Kene-ok/ecocar_onboarding_2627/EcoCar Onboarding 26_27.kicad_pcb

## KiCad design EcoCar Onboarding 26_27.kicad_pcb (2026-11-03)

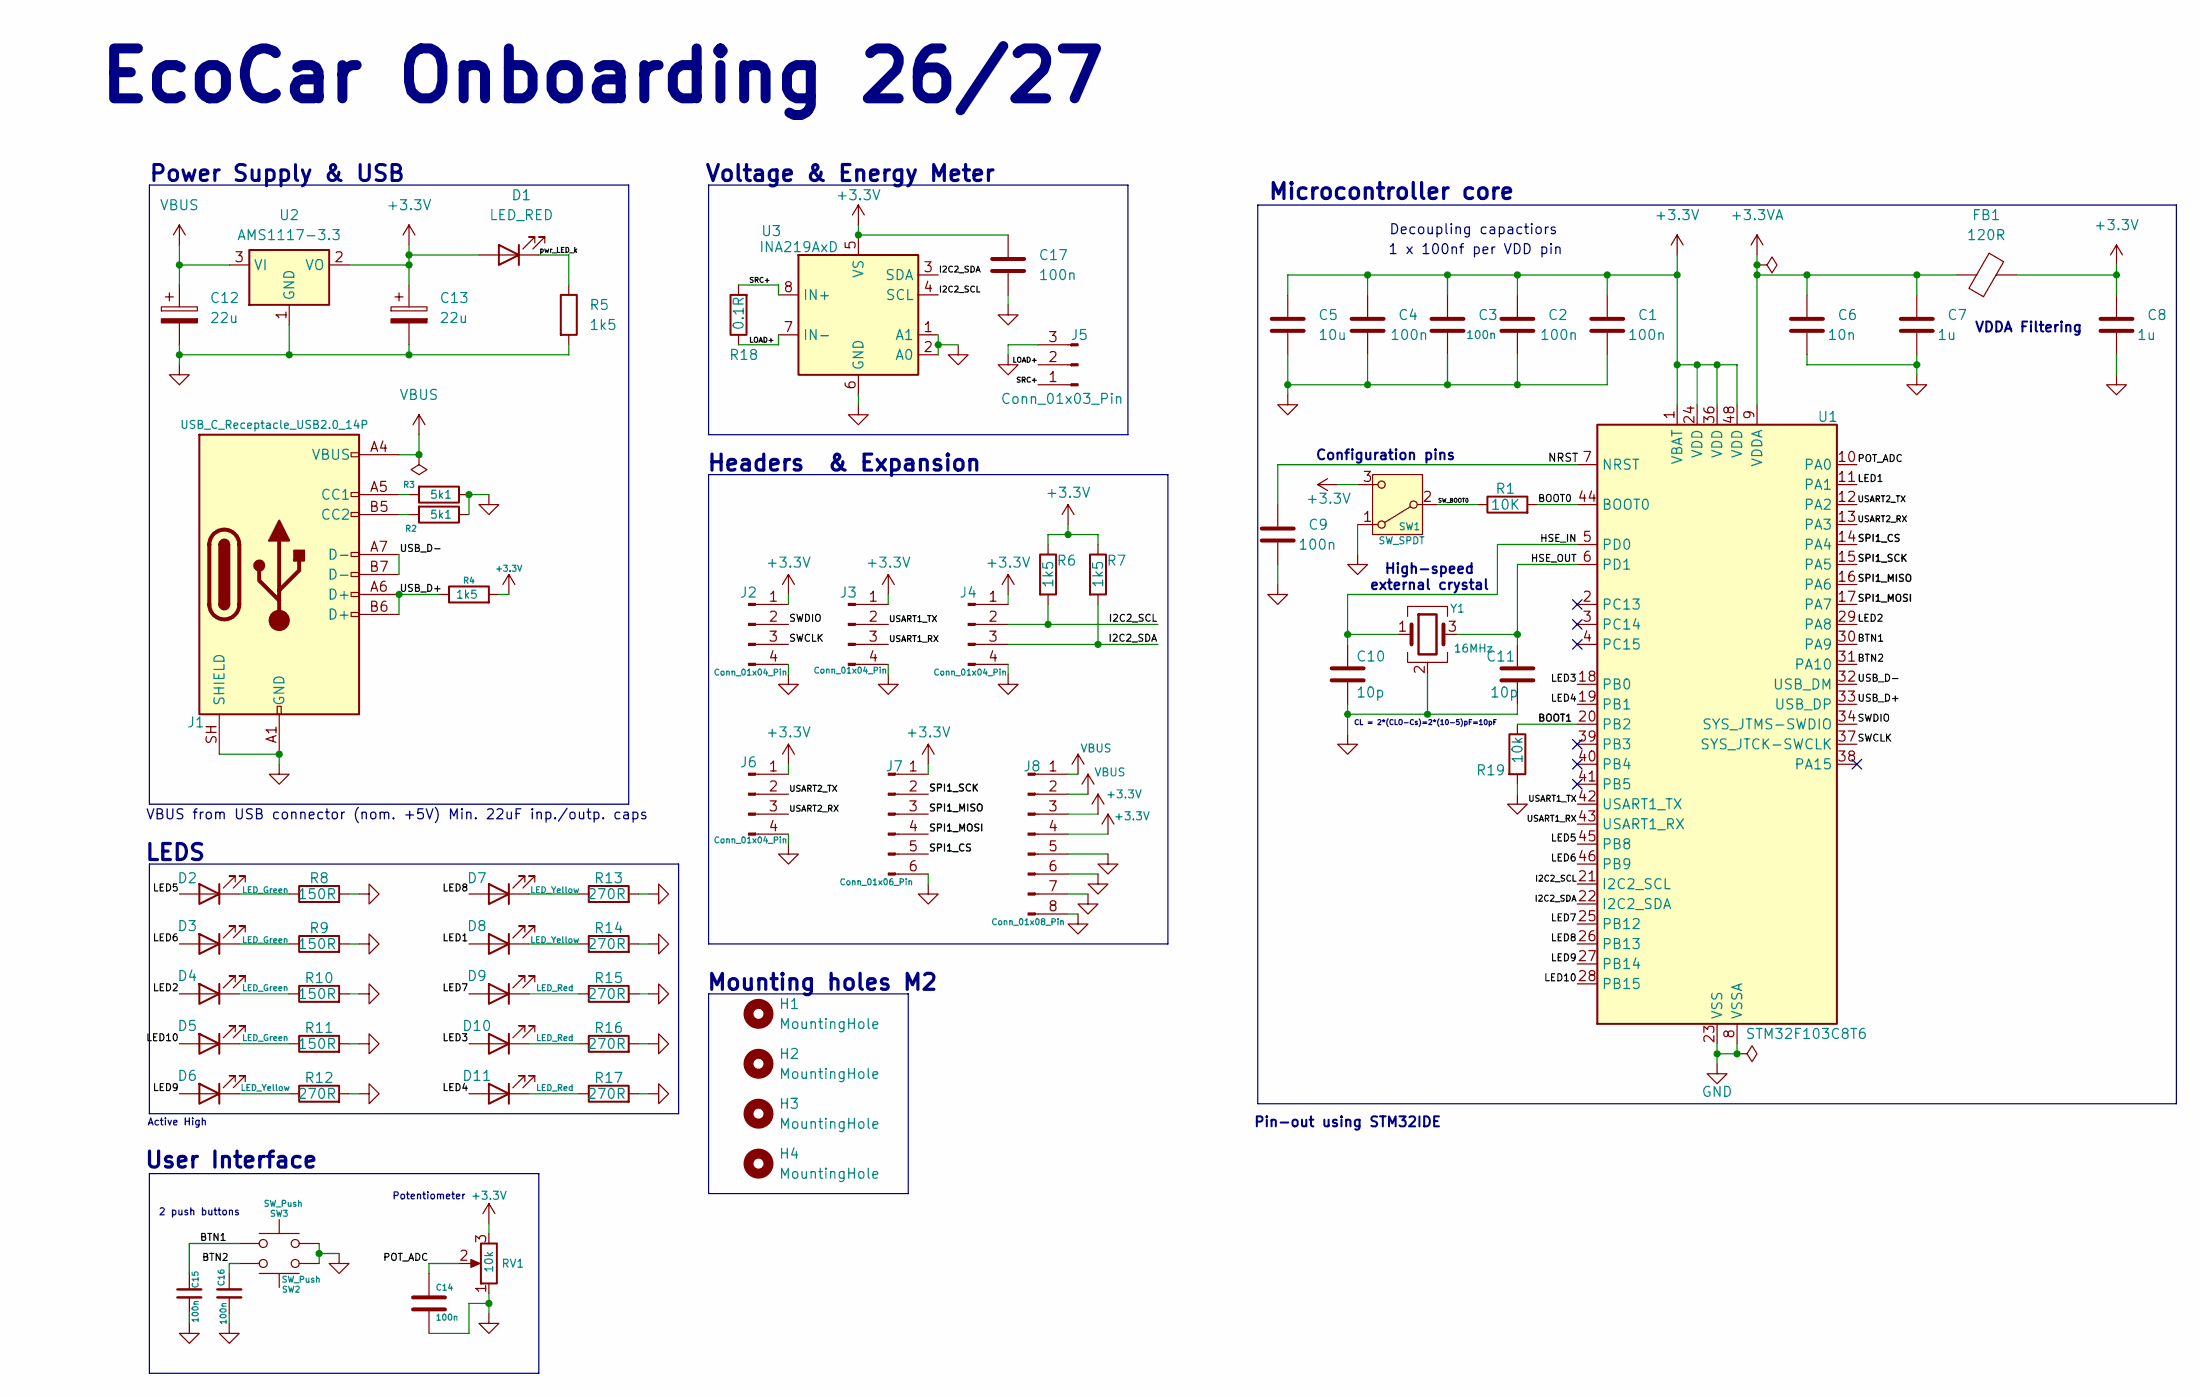
[picture p1: schematic EcoCar Onboarding 26_27.kicad_sch, EcoCar Onboarding 26/27]

Parts:
C1, C2, C3, C4, C9, C14, C15, C16, C17: 100n; C_0603_1608Metric_Pad1.08x0.95mm_HandSolder
C5: 10u; C_0603_1608Metric_Pad1.08x0.95mm_HandSolder
C6: 10n; C_0603_1608Metric_Pad1.08x0.95mm_HandSolder
C7, C8: 1u; C_0603_1608Metric_Pad1.08x0.95mm_HandSolder
C10, C11: 10p; C_0603_1608Metric_Pad1.08x0.95mm_HandSolder
C12, C13: 22u; CP_EIA-3216-18_Kemet-A
D1: LED_RED; LED_0603_1608Metric_Pad1.05x0.95mm_HandSolder
D2, D3, D4, D5: LED_Green; LED_0603_1608Metric_Pad1.05x0.95mm_HandSolder
D6, D7, D8: LED_Yellow; LED_0603_1608Metric_Pad1.05x0.95mm_HandSolder
D9, D10, D11: LED_Red; LED_0603_1608Metric_Pad1.05x0.95mm_HandSolder
FB1: 120R; L_0603_1608Metric_Pad1.05x0.95mm_HandSolder
H1, H2, H3, H4: MountingHole; MountingHole_2.2mm_M2_DIN965
J1: USB_C_Receptacle_USB2.0_14P; USB_C_Receptacle_HRO_TYPE-C-31-M-12
J2, J3, J4, J6: Conn_01x04_Pin; PinHeader_1x04_P2.54mm_Vertical
J5: Conn_01x03_Pin; PinHeader_1x03_P2.54mm_Vertical
J7: Conn_01x06_Pin; PinHeader_1x06_P2.54mm_Vertical
J8: Conn_01x08_Pin; PinHeader_1x08_P2.54mm_Vertical
R1: 10K; R_0603_1608Metric_Pad0.98x0.95mm_HandSolder
R2, R3: 5k1; R_0603_1608Metric_Pad0.98x0.95mm_HandSolder
R4, R5, R6, R7: 1k5; R_0603_1608Metric_Pad0.98x0.95mm_HandSolder
R8, R9, R10, R11: 150R; R_0603_1608Metric_Pad0.98x0.95mm_HandSolder
R12, R13, R14, R15, R16, R17: 270R; R_0603_1608Metric_Pad0.98x0.95mm_HandSolder
R18: 0.1R; R_1206_3216Metric_Pad1.30x1.75mm_HandSolder
R19: 10k; R_0603_1608Metric_Pad0.98x0.95mm_HandSolder
RV1: 10k; Potentiometer_Alpha_RD901F-40-00D_Single_Vertical
SW1: SW_SPDT; SW_Slide_SPDT_Straight_CK_OS102011MS2Q
SW2, SW3: SW_Push; SW_PUSH_6mm
U1: STM32F103C8T6; LQFP-48_7x7mm_P0.5mm
U2: AMS1117-3.3; SOT-223-3_TabPin2
U3: INA219AxD; SOIC-8_3.9x4.9mm_P1.27mm
Y1: 16MHz; Crystal_SMD_3225-4Pin_3.2x2.5mm_HandSoldering

Connections:
+3.3V: C1.1, C2.1, C3.1, C4.1, C5.1, C8.1, C13.1, C17.1, D1.2 (A), FB1.2, J2.1, J3.1, J4.1, J6.1, J7.1, J8.3, J8.4, R4.2, R6.1, R7.1, RV1.3, SW1.3 (C), U1.1 (VBAT), U1.24 (VDD), U1.36 (VDD), U1.48 (VDD), U2.2 (VO), U3.5 (VS)
+3.3VA: C6.1, C7.1, FB1.1, U1.9 (VDDA)
/BOOT0: R1.2, U1.44 (BOOT0)
/BOOT1: R19.1, U1.20 (PB2)
/BTN1: C15.1, SW3.1, U1.30 (PA9)
/BTN2: C16.1, SW2.2, U1.31 (PA10)
/HSE_IN: C10.1, U1.5 (PD0), Y1.1
/HSE_OUT: C11.1, U1.6 (PD1), Y1.3
/I2C2_SCL: J4.2, R6.2, U1.21 (I2C2_SCL), U3.4 (SCL)
/I2C2_SDA: J4.3, R7.2, U1.22 (I2C2_SDA), U3.3 (SDA)
/LED1: D8.2 (A), U1.11 (PA1)
/LED2: D4.2 (A), U1.29 (PA8)
/LED3: D10.2 (A), U1.18 (PB0)
/LED4: D11.2 (A), U1.19 (PB1)
/LED5: D2.2 (A), U1.45 (PB8)
/LED6: D3.2 (A), U1.46 (PB9)
/LED7: D9.2 (A), U1.25 (PB12)
/LED8: D7.2 (A), U1.26 (PB13)
/LED9: D6.2 (A), U1.27 (PB14)
/LED10: D5.2 (A), U1.28 (PB15)
/LOAD+: J5.2, R18.1, U3.7 (IN-)
/NRST: C9.1, U1.7 (NRST)
/POT_ADC: C14.1, RV1.2, U1.10 (PA0)
/SPI1_CS: J7.5, U1.14 (PA4)
/SPI1_MISO: J7.3, U1.16 (PA6)
/SPI1_MOSI: J7.4, U1.17 (PA7)
/SPI1_SCK: J7.2, U1.15 (PA5)
/SRC+: J5.1, R18.2, U3.8 (IN+)
/SWCLK: J2.3, U1.37 (SYS_JTCK-SWCLK)
/SWDIO: J2.2, U1.34 (SYS_JTMS-SWDIO)
/SW_BOOT0: R1.1, SW1.2 (B)
/USART1_RX: J3.3, U1.43 (USART1_RX)
/USART1_TX: J3.2, U1.42 (USART1_TX)
/USART2_RX: J6.3, U1.13 (PA3)
/USART2_TX: J6.2, U1.12 (PA2)
/USB_D+: J1.A6 (D+), J1.B6 (D+), R4.1, U1.33 (USB_DP)
/USB_D-: J1.A7 (D-), J1.B7 (D-), U1.32 (USB_DM)
/pwr_LED_k: D1.1 (K), R5.1
GND: C1.2, C2.2, C3.2, C4.2, C5.2, C6.2, C7.2, C8.2, C9.2, C10.2, C11.2, C12.2, C13.2, C14.2, C15.2, C16.2, C17.2, J1.A1 (GND), J1.A12 (GND), J1.B1 (GND), J1.B12 (GND), J1.SH (SHIELD), J2.4, J3.4, J4.4, J5.3, J6.4, J7.6, J8.5, J8.6, J8.7, J8.8, R2.1, R3.1, R5.2, R8.2, R9.2, R10.2, R11.2, R12.2, R13.2, R14.2, R15.2, R16.2, R17.2, R19.2, RV1.1, SW1.1 (A), SW2.1, SW3.2, U1.8 (VSSA), U1.23 (VSS), U1.35 (VSS), U1.47 (VSS), U2.1 (GND), U3.1 (A1), U3.2 (A0), U3.6 (GND), Y1.2 (G), Y1.4 (G)
unnamed: D2.1 (K), R8.1
unnamed: D3.1 (K), R9.1
unnamed: D4.1 (K), R10.1
unnamed: D5.1 (K), R11.1
unnamed: D6.1 (K), R12.1
unnamed: D7.1 (K), R13.1
unnamed: D8.1 (K), R14.1
unnamed: D9.1 (K), R15.1
unnamed: D10.1 (K), R16.1
unnamed: D11.1 (K), R17.1
unnamed: J1.A5 (CC1), R3.2
unnamed: J1.B5 (CC2), R2.2
VBUS: C12.1, J1.A4 (VBUS), J1.A9 (VBUS), J1.B4 (VBUS), J1.B9 (VBUS), J8.1, J8.2, U2.3 (VI)

Notes on the sheet:
Active High
VBUS from USB connector (nom. +5V) Min. 22uF inp./outp. caps
Power Supply & USB
Voltage & Energy Meter
Pin-out using STM32IDE
CL = 2*(CLO-Cs)=2*(10-5)pF=10pF
High-speed external crystal
Potentiometer
EcoCar Onboarding 26/27
Headers & Expansion
Decoupling capactiors
1 x 100nf per VDD pin
Configuration pins
2 push buttons
VDDA Filtering
LEDS
User Interface
Microcontroller core
Mounting holes M2

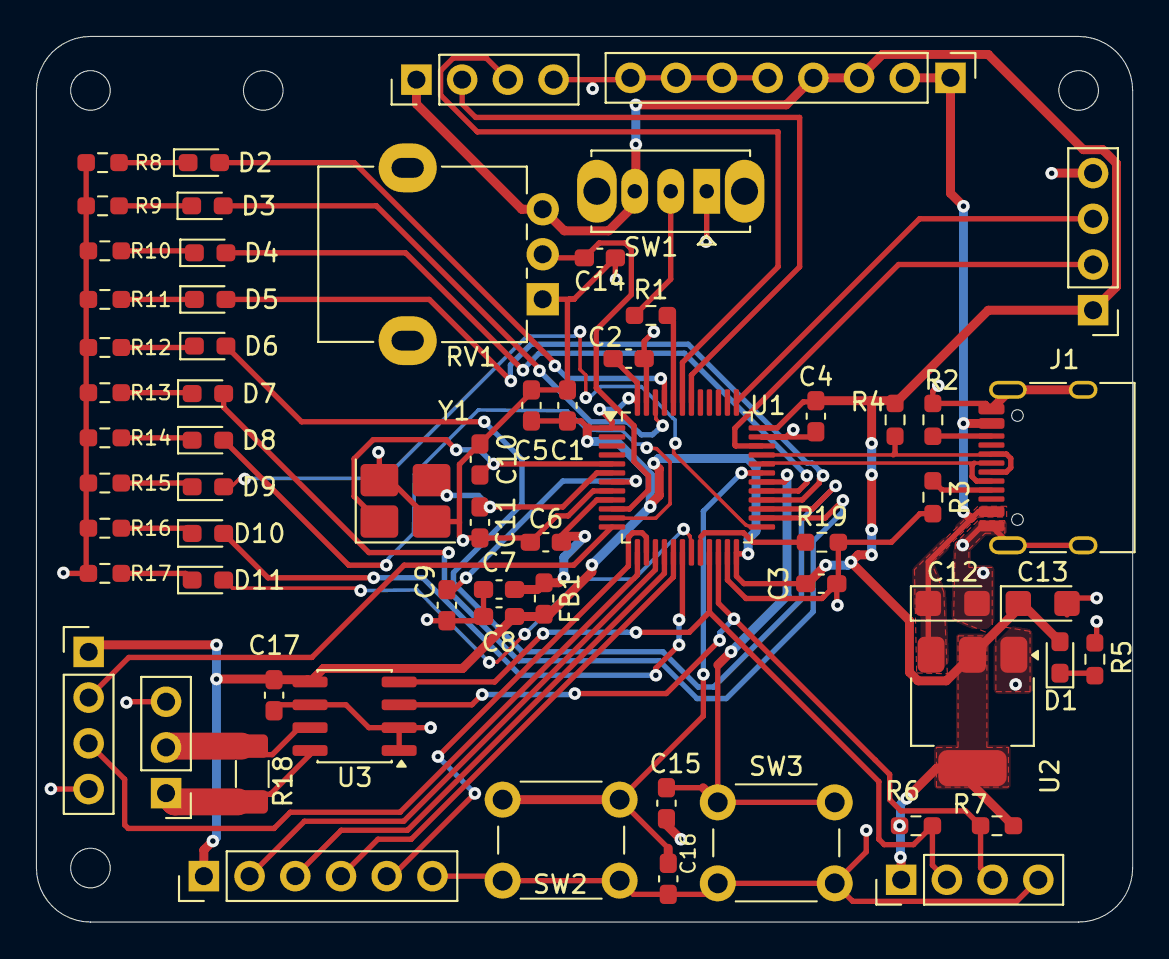
[picture p2: board EcoCar Onboarding 26_27.kicad_pcb from above]

Board: 2 copper layers, 60.9 x 49.2 mm, 68 parts (0 on the bottom side), 52 nets.
